krishna192219/Self-Balancing-robot/media/photos/boost_module.jpeg

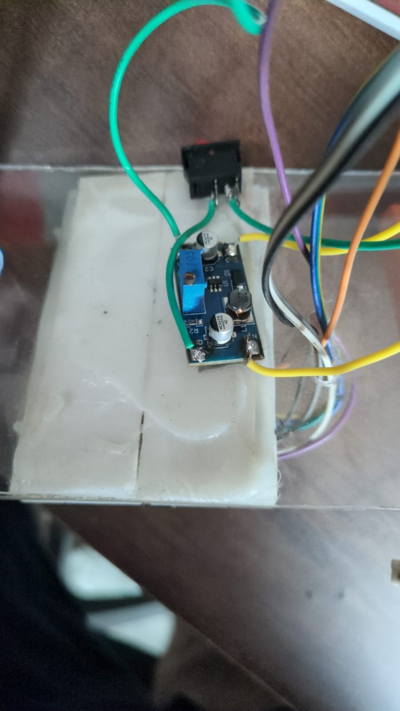
media/photos/boost_module.jpeg
