krishna192219/Self-Balancing-robot/media/photos/STRUCTURE.jpeg

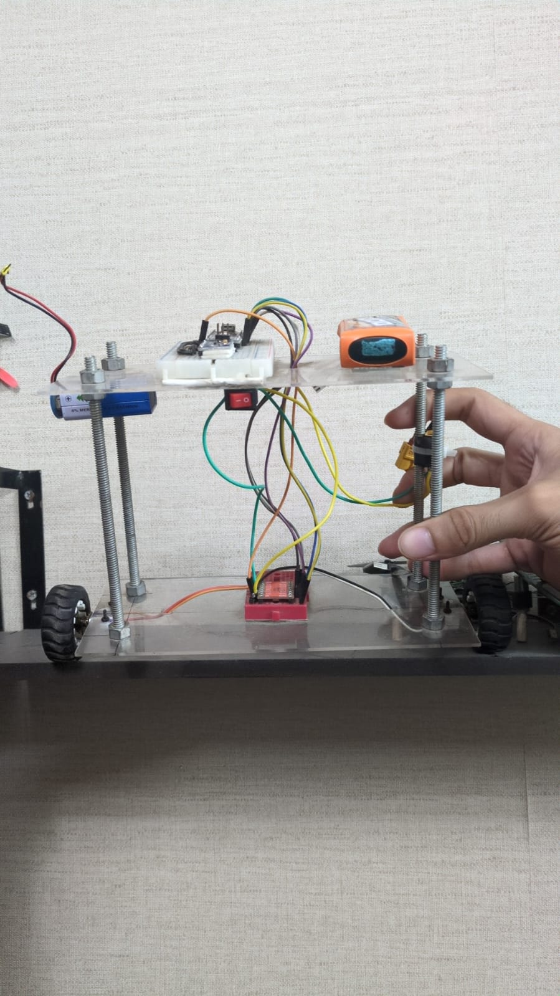
media/photos/STRUCTURE.jpeg
