krishna192219/Self-Balancing-robot/README.md

# Self-Balancing-robot
A two wheeled self balancing robot build using Arduino and mpu6050 

This project is a two-wheel self-balancing robot designed to maintain an upright position using real-time feedback control. The robot is based on the principle of an inverted pendulum, an inherently unstable system in which the wheels must continuously move beneath the robot's center of mass to prevent it from falling. When an external disturbance pushes the robot away from its balance point, the controller detects the change in tilt and drives the motors in the required direction to recover and return the robot to its upright position.

## 🎥 Demonstration

https://github.com/user-attachments/assets/ef3872db-a0dd-4728-b262-816b82042763

The robot maintains its upright position using real-time tilt estimation
and PID feedback control. When an external disturbance is applied, the
controller drives the wheels to recover the robot and return it toward
its balance point.

## Hardware and Mechanical Design

### Arduino Nano — Main Controller
WhatsApp Image 2026-07-17 at 01 14 41

The Arduino Nano acts as the main controller of the robot. It continuously
reads data from the IMU, estimates the tilt angle, executes the PID control
algorithm, and generates PWM signals for the motor driver.

I chose the Nano because its compact form factor fits well within the robot's
frame while still providing the required I/O, PWM outputs, and processing
capability for the control loop.

---

### MPU6050 — Inertial Measurement Unit


The MPU6050 is a 6-DOF IMU containing a 3-axis accelerometer and a 3-axis
gyroscope. It is used to estimate the forward and backward tilt of the robot.

The gyroscope provides fast angular-rate measurements, while the accelerometer
provides an absolute reference for orientation. Since the gyroscope is affected
by long-term drift and the accelerometer is sensitive to vibration and linear
acceleration, I combine both measurements using a complementary filter.

For the physical mounting orientation used in this robot, the pitch estimation
uses the AY accelerometer axis and GX gyroscope axis. 
During the development of the robot, I encountered compatibility issues with the available MPU6050 libraries, which prevented reliable communication with the IMU. Instead of relying on a high-level library, I implemented direct I²C register-level communication between the Arduino Nano and the IMU.

The sensor is initialized by writing directly to its configuration registers, including the power management, digital low-pass filter, gyroscope range, and accelerometer range registers. The raw accelerometer and gyroscope measurements are then read directly from the sensor's data registers over I²C.

This approach gave me greater control over the sensor configuration and also helped me understand how the IMU communicates at a lower level rather than treating it as a black box. The raw AY, AZ, and GX measurements required for balancing are extracted directly and used for tilt estimation. At startup, the robot also collects multiple stationary samples to calculate the gyroscope bias and accelerometer mounting offset, reducing the effect of sensor bias and small mechanical misalignment.

---

### TB6612FNG — Motor Driver
WhatsApp Image 2026-07-16 at 23 49 08

The two N20 motors are controlled using a TB6612FNG dual H-bridge motor driver.

I selected the TB6612FNG because it is compact, efficient, supports independent
bidirectional control of two DC motors, and responds well to high-frequency PWM
signals. These characteristics are important for a balancing robot, where the
motors must continuously make rapid changes in speed and direction.

---

### N20 Geared DC Motors
WhatsApp Image 2026-07-16 at 23 49 08(1)

The robot uses two 400 RPM N20 geared DC motors.

A self-balancing robot requires both sufficient torque and fast wheel response.
The geared motors provide enough torque to accelerate the robot while their
relatively high output speed allows the controller to quickly move the wheels
beneath the robot's center of mass when it begins to fall. They are mounted firmly 
with the help of n20 motors bracket.And they use 43mm rubber wheels which provides 
decent grip when balancing.

During development, I also experimentally determined the minimum PWM required
to overcome the static friction of the motors and gearbox. This value is used
for motor deadzone compensation in the firmware.

---

## Power System

<p align="center">
  Self-Balancing Robot Side View
  &nbsp;&nbsp;
  Self-Balancing Robot Front View
</p>

The robot uses two separate power sources for the control electronics and the motors. This separation helps prevent the high current demand and electrical noise generated by the motors from directly affecting the Arduino and sensor electronics.

A **12 V, 1000 mAh, 30C LiPo battery** is used as the main motor power source and supplies the motor side of the TB6612FNG motor driver. The high discharge capability of the LiPo allows it to provide the current required during rapid acceleration, direction changes, and recovery from external disturbances.

A separate **9 V battery** powers the Arduino Nano through its regulated input. The Arduino then powers the low-voltage control electronics, including the IMU. Using a dedicated supply for the controller provides some isolation between the motor power system and the sensitive control electronics.

Both power systems share a **common ground**, which is necessary so that the PWM and direction signals generated by the Arduino have the same voltage reference as the TB6612FNG motor driver.

---

XL6009 DC-DC Boost Converter



An XL6009 adjustable DC-DC boost converter is used in the motor power system to provide a more consistent supply voltage as the battery discharges. The converter is adjusted to provide approximately 12 V to the motor driver, helping reduce changes in motor performance caused by the gradual decrease in battery voltage during operation.

Maintaining a more consistent motor supply is particularly useful for a self-balancing robot because the response of the motors directly affects the behavior of the PID controller. Significant changes in motor speed and torque as the battery discharges can alter the dynamics of the system and affect the tuning of the controller.

## Mechanical Design


The robot chassis was designed around the inverted-pendulum principle. Two
3mm acrylic sheets having width 9cm length 21cm and they both are placed at a distance of 14cm
and are connected using threaded metal
bolt of 16cm, nuts, and spacers.

The motors and wheels are mounted at the bottom of the structure, while the
battery and control electronics are positioned higher on the chassis this keeps
the center of mass towards the top which helps the robot to fall slower and have 
enough time to react.
The vertical structure provides space for mounting and experimenting with different
component positions during development.

The prototype uses a modular construction approach rather than a permanently
fixed enclosure. This makes the electronics easily accessible and allows the
position of individual components to be adjusted while testing the effect of
weight distribution and center of mass on balancing performance.

---

### Hardware Architecture
## Wiring Schematic



The complete wiring schematic for the self-balancing robot was designed using EasyEDA. The schematic provides a clear overview of the electrical connections between the Arduino Nano, IMU, TB6612FNG motor driver, N20 geared motors, and the power system.

The control electronics and motors use separate power sources. The Arduino Nano and IMU are powered independently from the motor power system, while the 12 V LiPo battery supplies the motors through the XL6009 DC-DC converter and TB6612FNG motor driver. All components share a common ground to provide a common reference for the control signals.

The schematic also shows the I²C connection between the Arduino Nano and the IMU, along with the PWM and direction-control connections used to interface the Arduino with the motor driver.

The overall hardware flow is:

    MPU6050
        |
        v
    Arduino Nano
        |
    PID Controller
        |
        v
    TB6612FNG
       / \
      v   v
    Left  Right
    Motor Motor

## Challenges and Engineering Solutions

Building a self-balancing robot involved much more than simply connecting the components and implementing a PID controller. Since the robot is an inherently unstable system, even small issues with sensor measurements, motor response, control-loop timing, or PID parameters had a significant effect on its ability to balance. The following were some of the major challenges I encountered during development.

### 1. IMU Communication and Library Compatibility

One of the first major problems I faced was with the IMU. The sensor was not communicating reliably with the MPU6050 libraries I initially tried to use. After testing the I²C communication and verifying the hardware connections, I decided to remove the dependency on the external IMU library entirely.

Instead, I implemented direct register-level communication using Arduino's `Wire` library. The IMU is initialized by directly configuring its power management, digital low-pass filter, gyroscope range, and accelerometer range registers. The required raw sensor values are then read directly from the data registers.

Although this required more low-level implementation, it gave me better control over the sensor and helped me understand how I²C sensors communicate at the register level.

---

### 2. Finding the Correct IMU Axes

The physical orientation of the IMU on the robot meant that the expected sensor axes did not initially correspond to the robot's forward and backward motion.

In one of my early implementations, tilting the robot forward or backward produced almost no response, while tilting it sideways caused the motors to move. To solve this, I monitored the individual accelerometer and gyroscope readings while manually moving the robot along different axes.

Through this testing, I determined that the combination required for my mounting orientation was:

- `AY` and `AZ` for calculating the accelerometer tilt angle
- `GX` for measuring the angular velocity

The final control system therefore uses these specific axes for pitch estimation.

---

### 3. IMU Offset and Calibration

Even when the robot was physically positioned at its balance point, the IMU did not always report exactly zero degrees. Small sensor offsets and slight differences in the physical mounting angle caused the controller to continuously command the motors in one direction.

To compensate for this, I implemented an automatic calibration routine that runs when the robot starts. While the robot is held stationary at its desired balancing position, the program collects 1000 sensor samples.

The average gyroscope measurement is used to calculate the gyroscope bias, while the average accelerometer angle is stored as the mounting-angle offset. These values are then subtracted from subsequent measurements so that the physical balancing position of the robot becomes the zero reference for the controller.

---

### 4. Dealing with Sensor Noise and Gyroscope Drift

Using only the accelerometer produced noisy angle measurements because the sensor also responds to vibration and linear acceleration. On the other hand, calculating the angle using only the gyroscope resulted in gradual drift over time.

To overcome this, I implemented a complementary filter that combines both measurements. The gyroscope is given more weight for detecting fast changes in orientation, while the accelerometer provides a long-term reference that corrects accumulated gyro drift.

The IMU's internal digital low-pass filter is also configured to reduce high-frequency sensor noise before the measurements are used by the controller.

---

### 5. Motor Deadzone and Nonlinear Response

During testing, I found that the motors did not start rotating immediately when a small PWM signal was applied. The controller could therefore be producing a correction while the actual wheels remained stationary because the command was not large enough to overcome the static friction of the motors and gearboxes.

I tested the motors separately by gradually changing the PWM value and observing the point at which they started rotating. This allowed me to estimate the minimum useful motor command and implement deadzone compensation in the firmware.

This was particularly important for balancing because small but fast corrections are required around the upright position.

---

### 6. PID Tuning

PID tuning was one of the most time-consuming parts of the project. Initially, the robot was unable to recover from the first fall because the proportional response was not strong enough. Increasing the proportional gain improved the response, but excessive values caused continuous oscillations around the balance point.

The derivative term was then used to provide damping and reduce these oscillations. Instead of numerically calculating the derivative of the estimated angle, I used the angular velocity measured directly by the gyroscope. This provided a more direct measurement of the robot's rotational motion without amplifying noise through numerical differentiation.

The integral gain was kept relatively small and used to compensate for persistent errors around the balance point.

The final PID parameters were determined experimentally by repeatedly testing the physical robot and observing its response to both natural falls and external disturbances.

---

### 7. Maintaining Consistent Motor Performance

Another challenge was that motor behavior could change as the LiPo battery discharged. Since the response of the motors directly affects the dynamics of the robot, changes in the available motor voltage could also affect the performance of the PID controller.

To make the motor supply more consistent as the battery voltage decreased, I added an adjustable XL6009 DC-DC boost converter to the motor power system and configured its output to approximately 12 V.

This helped provide more consistent motor behavior during testing as the battery discharged.

---

### 8. Faster PID Tuning

During the early stages of development, changing a PID parameter required modifying the code, recompiling it, and uploading the entire program again. This made physical PID tuning slow and inconvenient.

To improve the tuning process, I implemented runtime parameter adjustment through serial communication. Parameters such as `Kp`, `Ki`, `Kd`, the balance setpoint, maximum motor output, and motor deadzone can be modified without recompiling the firmware.

For example:

    kp 31
    ki 1.0
    kd 0.22
    set 0
    max 250
    dead 10

This significantly reduced the time required to experiment with different controller parameters and observe their effect on the physical robot.

---

### What These Challenges Taught Me

The biggest lesson from this project was that building a real control system is very different from implementing the control equation alone. Sensor noise, calibration errors, motor friction, mechanical construction, power supply behavior, and loop timing all directly influence the performance of the controller.

Debugging these problems individually helped me develop a much better understanding of embedded control systems, IMU sensor processing, feedback control, motor behavior, and the practical challenges involved in implementing an unstable system such as an inverted pendulum on real hardware.

## Future Improvements and Features Considered

### Bluetooth-Based Remote Control

I initially planned to add a Bluetooth module to control the robot remotely and allow commands such as moving forward and backward while the robot continued balancing.

However, the current N20 motors do not have encoders. Although the controller knows the direction and PWM command being sent to each motor, it has no feedback about the actual wheel speed or distance travelled. Without this feedback, the robot cannot accurately determine its movement or position, which can cause it to continuously drift instead of performing controlled motion.

For this reason, I decided not to add remote movement control in the current version of the robot. In a future version, I plan to use motors with encoders and implement an additional velocity or position control loop alongside the existing balance controller. This would allow the robot to measure its wheel motion and perform more controlled forward, backward, and stationary balancing.

### Bluetooth-Based PID Tuning

I also considered adding a Bluetooth module for wireless PID tuning. The idea was to change `Kp`, `Ki`, `Kd`, and other controller parameters from a phone while the robot was running, instead of modifying and uploading the firmware after every adjustment.

I implemented support for changing the controller parameters at runtime through serial commands, which could also be extended to work with a Bluetooth serial module. However, during development I was able to experimentally find PID gains that produced satisfactory balancing performance before completing the Bluetooth interface.

Since wireless tuning was no longer necessary for the current prototype, I decided not to add the extra hardware and complexity. The runtime tuning functionality remains part of the firmware and could be connected to a Bluetooth module in a future version if further controller development is required.

The robot can maintain its upright position and react to external
disturbances by moving its wheels beneath its center of mass.
