krishna192219/Self-Balancing-robot/media/photos/ardiuno_IMU.jpeg

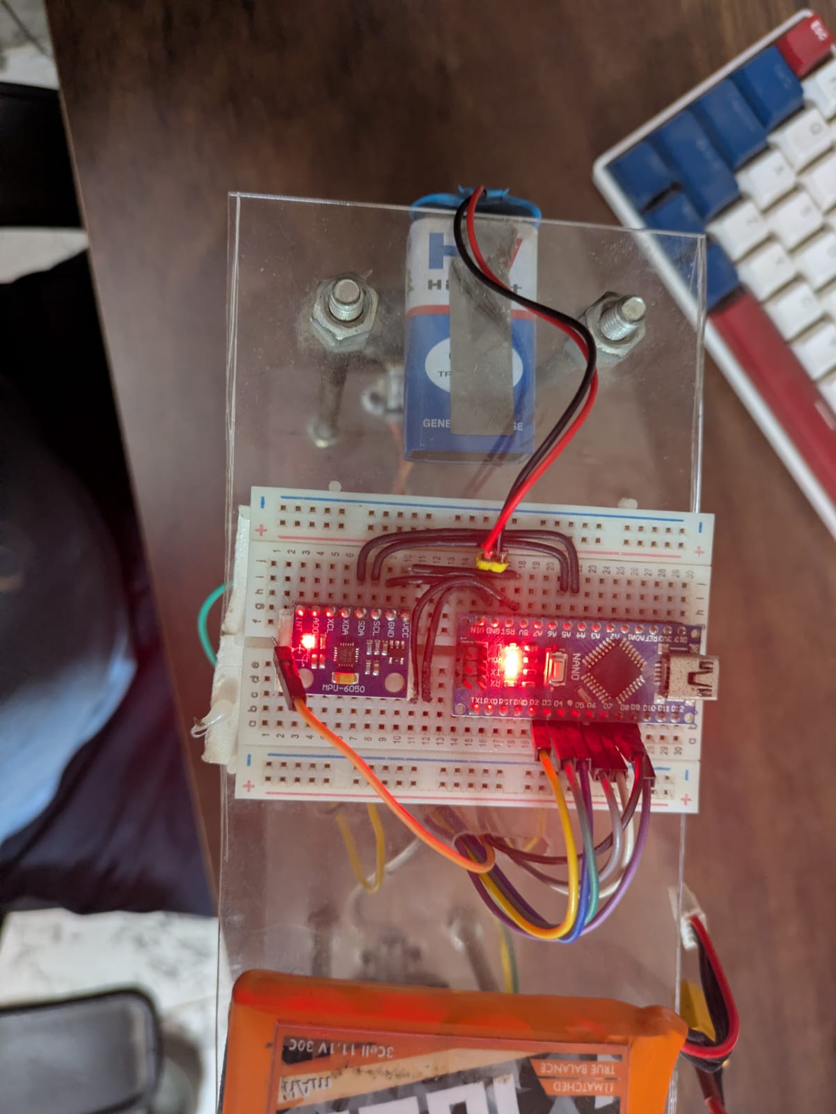
media/photos/ardiuno_IMU.jpeg
