krishna192219/Self-Balancing-robot/media/photos/Arduino_Battery_9v.jpeg

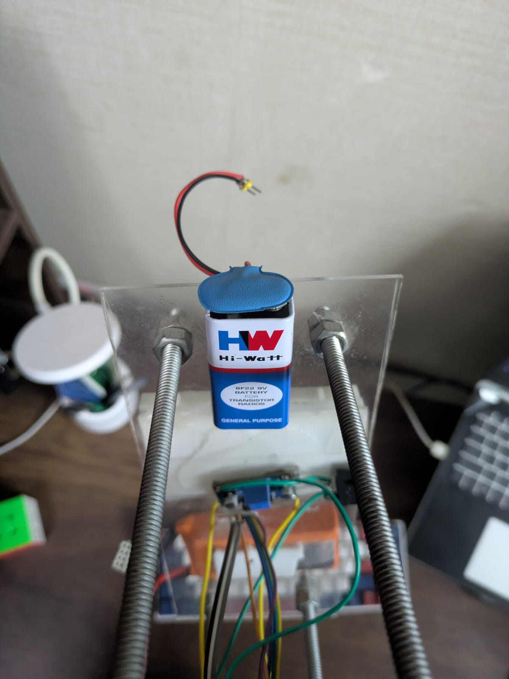
media/photos/Arduino_Battery_9v.jpeg
