krishna192219/Self-Balancing-robot/media/photos/Button.jpeg

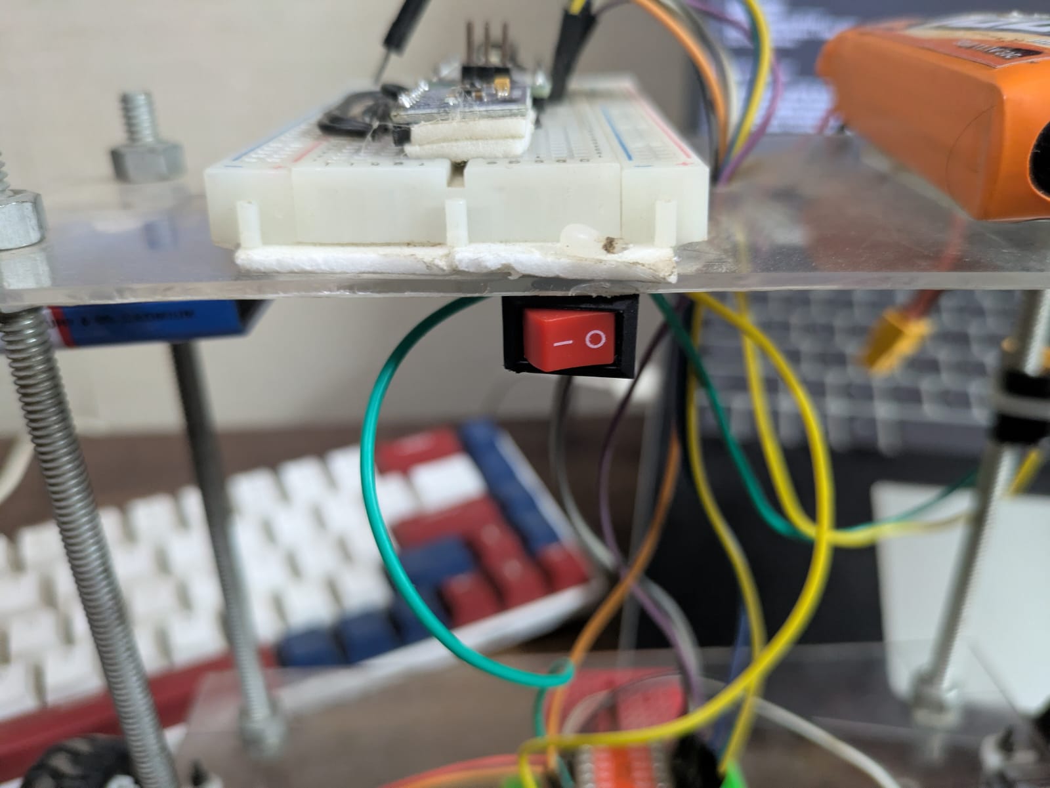
media/photos/Button.jpeg
