krishna192219/Self-Balancing-robot/media/photos/Lipo_Battery_Motor_12v.jpeg

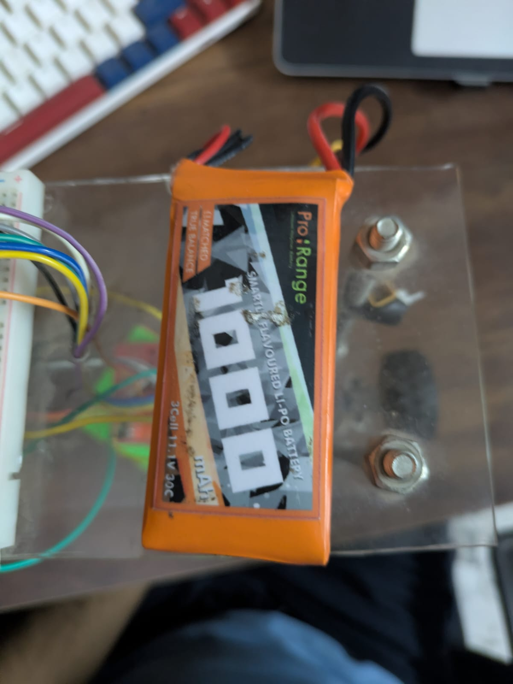
media/photos/Lipo_Battery_Motor_12v.jpeg
