krishna192219/Self-Balancing-robot/media/photos/motor_wheels.jpeg

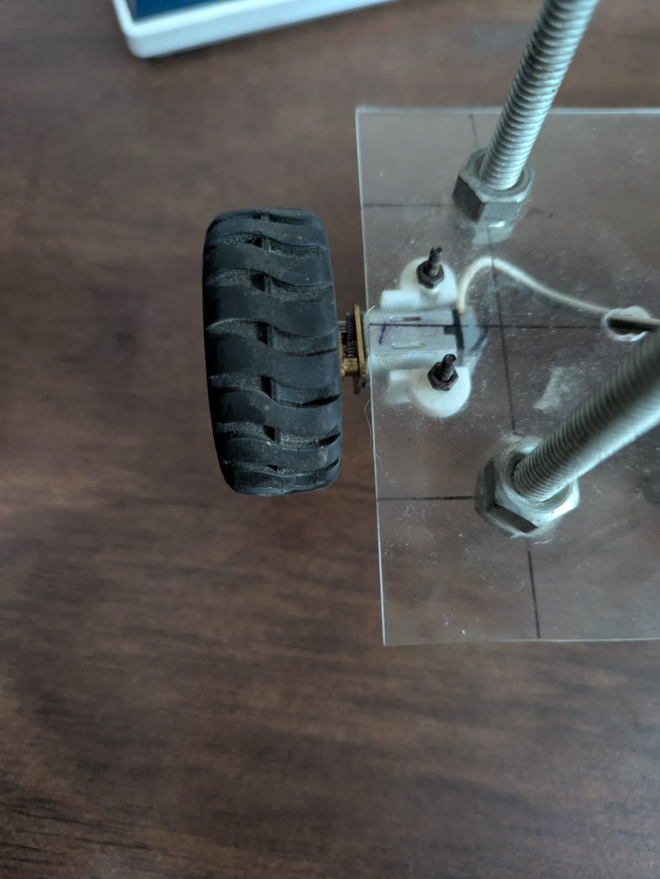
media/photos/motor_wheels.jpeg
