krishna192219/Self-Balancing-robot/media/photos/Self_Balancing_Robot.jpeg

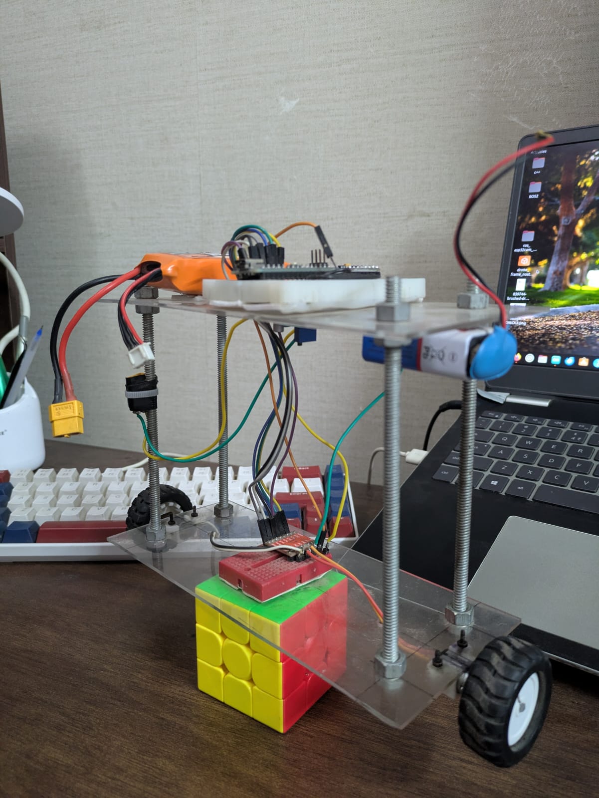
media/photos/Self_Balancing_Robot.jpeg
