krishna192219/Self-Balancing-robot/schematics/Wiring_diagram.png

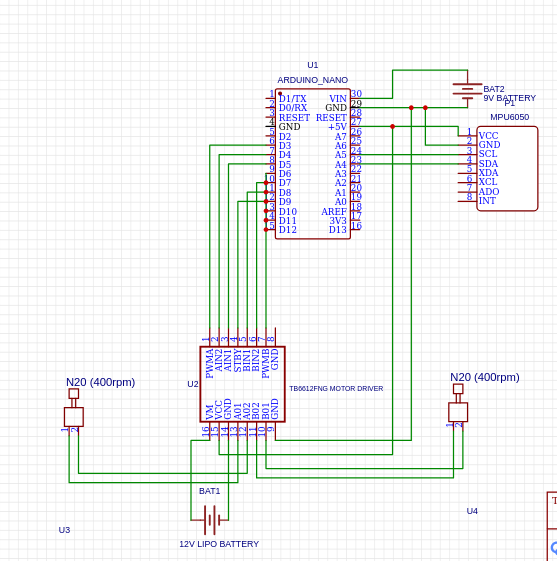
schematics/Wiring_diagram.png
