krishna192219/Self-Balancing-robot/(commit log)

2026-07-16 Enhance README with project details and diagrams
    Expanded the README to include detailed project description, hardware components, power system, mechanical design, and wiring schematic.
2026-07-16 Add challenges and solutions to README
    Expanded the README to detail challenges faced and engineering solutions implemented during the development of a self-balancing robot, including IMU communication, calibration, and PID tuning.
2026-07-16 change
    Corrected the spelling of 'Arduino' in the project description.
